jaclu010/Dora_explorer/src/pc/laptop/dora.png

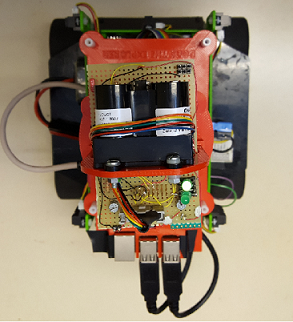
src/pc/laptop/dora.png
