jaclu010/Dora_explorer/README.md

Welcome to Dora the Explorer (KMM-TSEA29 Project), 
an automated robot platform to navigate through an unknown
environment. Documentation is only available in swedish.

Small demo:

Dora the Explorer (https://www.youtube.com/watch?v=opR7EzOlas0)
