jaclu010/Dora_explorer/src/pc/test_mapper/README.md

Use CONVERT_LOG.py to keep only laser readings from a log.
Speciy input and output inside CONVERT_LOG.py and make sure
MAPPER.py reads from correct output file.
