jaclu010/Dora_explorer/schematics/schematic.pdf

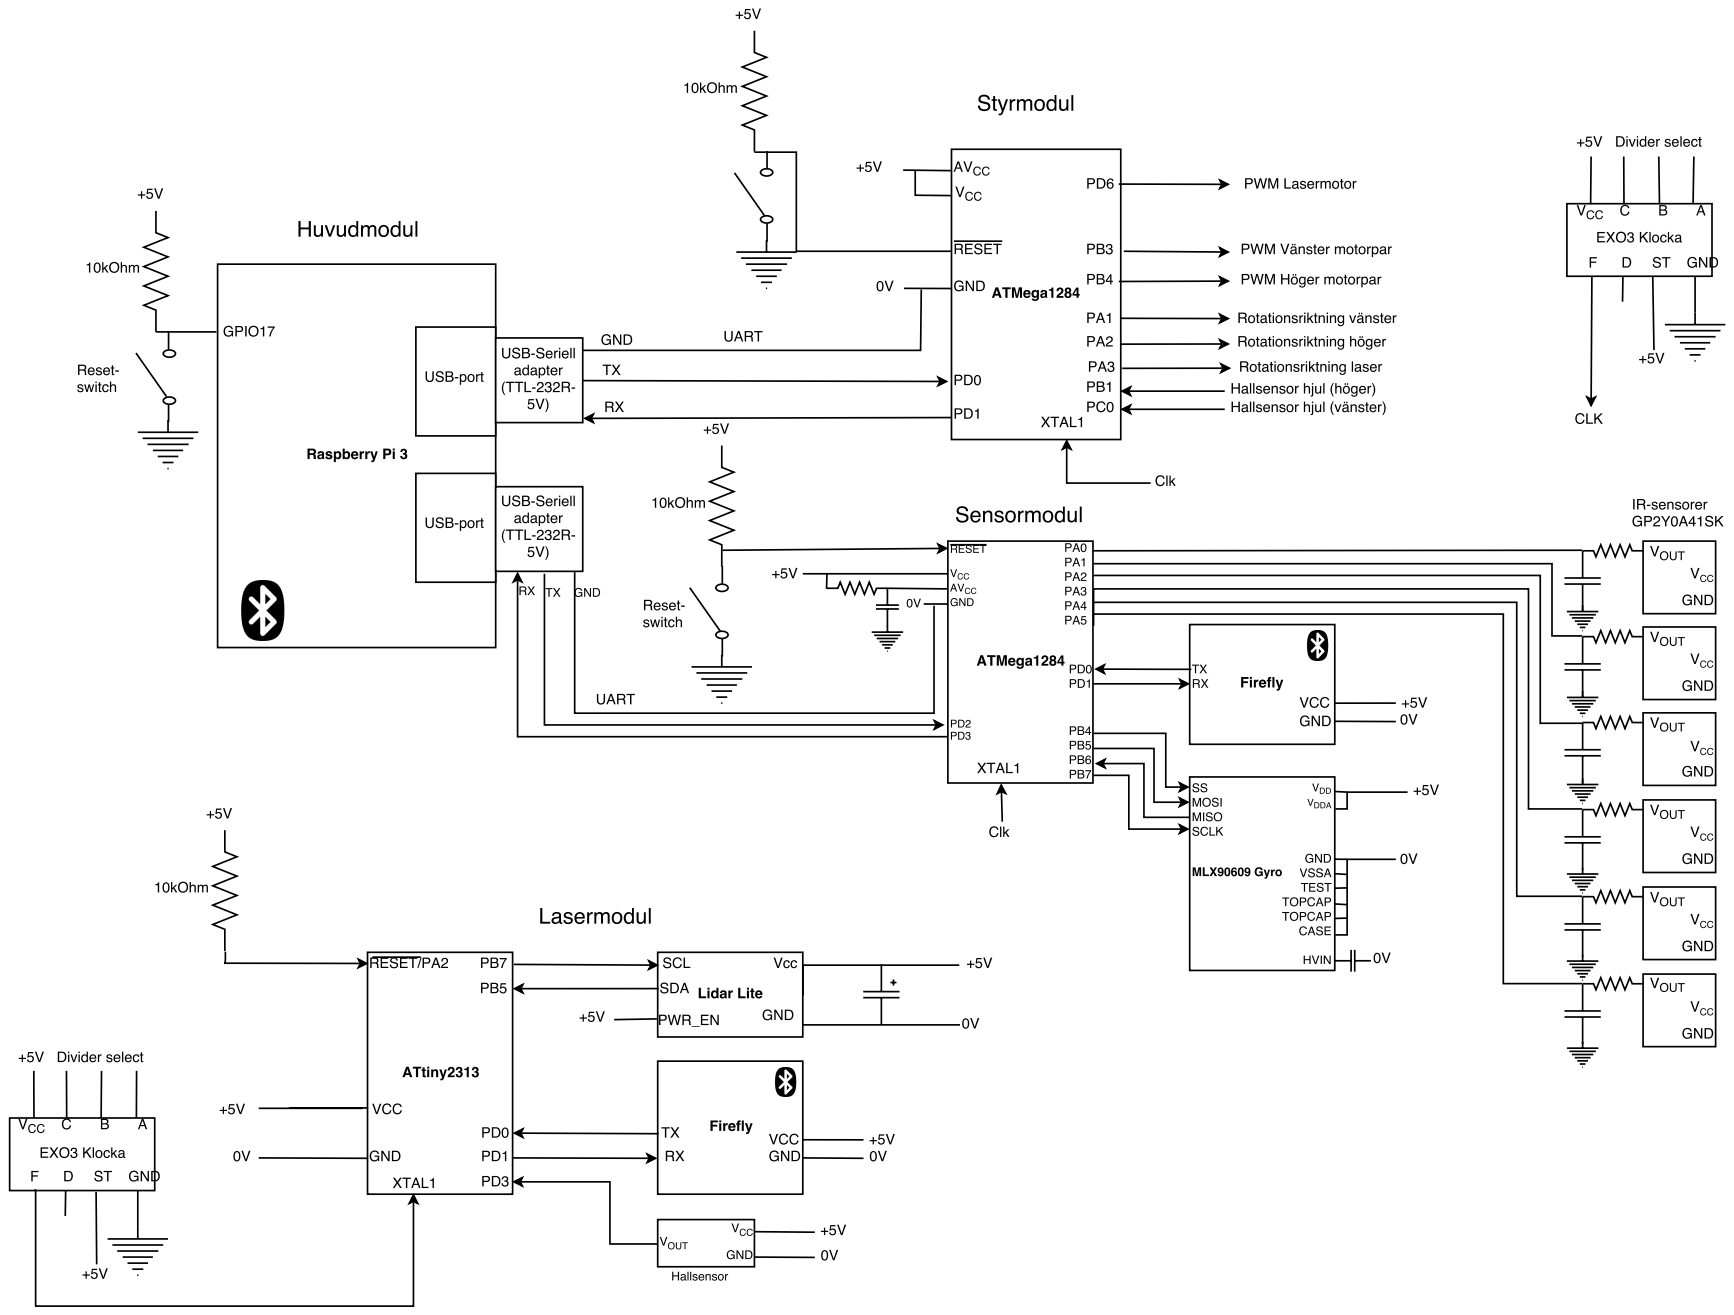
[picture p32: page 1]
