jaclu010/Dora_explorer/(commit log)

2016-11-03 Added threaded bluetooth communication to Dora. Program can send steering controls and receive sensor data.
2016-11-09 SensorModule directory
2016-11-09 Added SensorModule code
2016-11-09 Added laser code
2016-11-15 Added drawing laser lines. Bluetooth code works much better. More stable transmissions over BT. Bug fixes.
2016-11-17 Refactored sensor code.
2016-11-17 Fixed laser dots printed in reverse.
2016-11-17 Added ability to change speeds of the motors through the GUI.
2016-11-21 added filtering of intersecting points
2016-11-21 A "branch" of slam.py. Reads laser-data from a file and can display different iterations of the data. Also added the point of intersection between lines,
2016-11-21 This program generates a new txt-file containing only "laser-data" from the robot_log
2016-11-28 Changed to using processes in Dora. Added PID control algorithm.
2016-11-28 Fixed derivative of measurement in PID. Other small fixes and optimizations.
    [control.py]
2016-11-29 Fixed so floats can be sent from laptop for PID constants. Cleaned up repo.
    [blueztooth.py]
2016-11-29 Fixed so the laptop program can accept a new bluetooth connection without being restarted.
    [control.py]
2016-11-30 Fixed reading values into sensor overview.
2016-12-05 added buttons for foward left/right
2016-12-07 Added function to find closest unexplored tile in a grid. Fixed 3d drawing in lapop program.
    [path.py]
2016-12-13 completely rewrote final stage
2016-12-14 Upload sensor module project
2016-12-14 Add laser module project
2016-12-21 Some renaming, remove outcommented prints from slam_merger
2016-12-21 fix folder names, reomve unused
    [SensorModule1284P.c, SensorModule1284P.h, Styrmodul.c, steering.c, steering.h, uart.c, uart.h]
2016-12-21 added lasermodule2313
2016-12-21 added schematics
